Marcos-G/GHOST-LFRArduino-/correccion encoder derecho.png

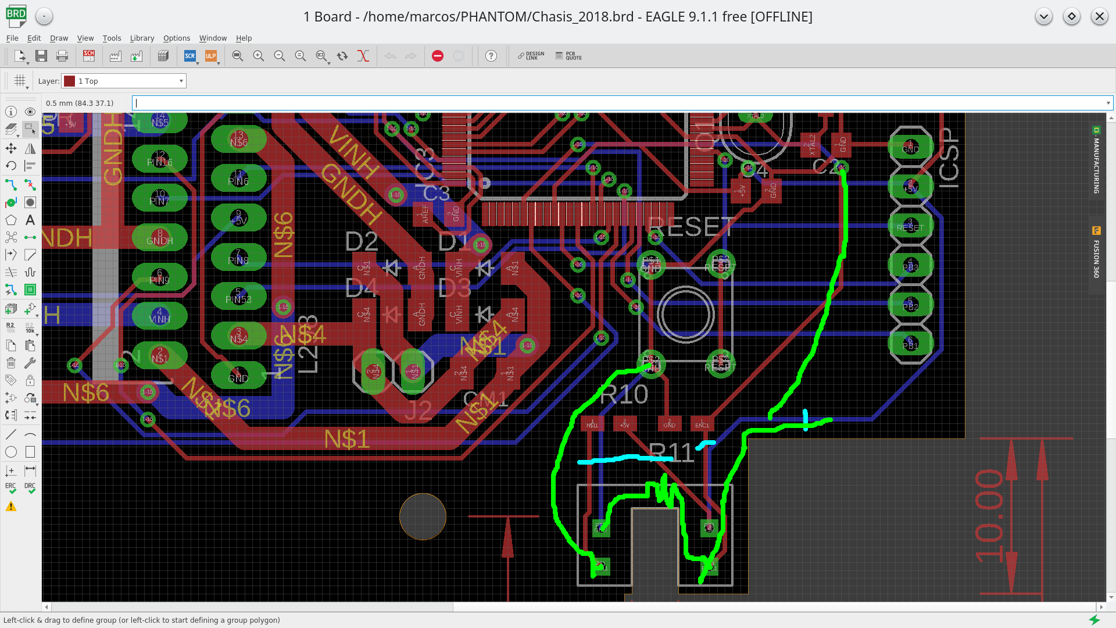
correccion encoder derecho.png
