Marcos-G/GHOST-LFRArduino-/correcion encoder izquierdo.png

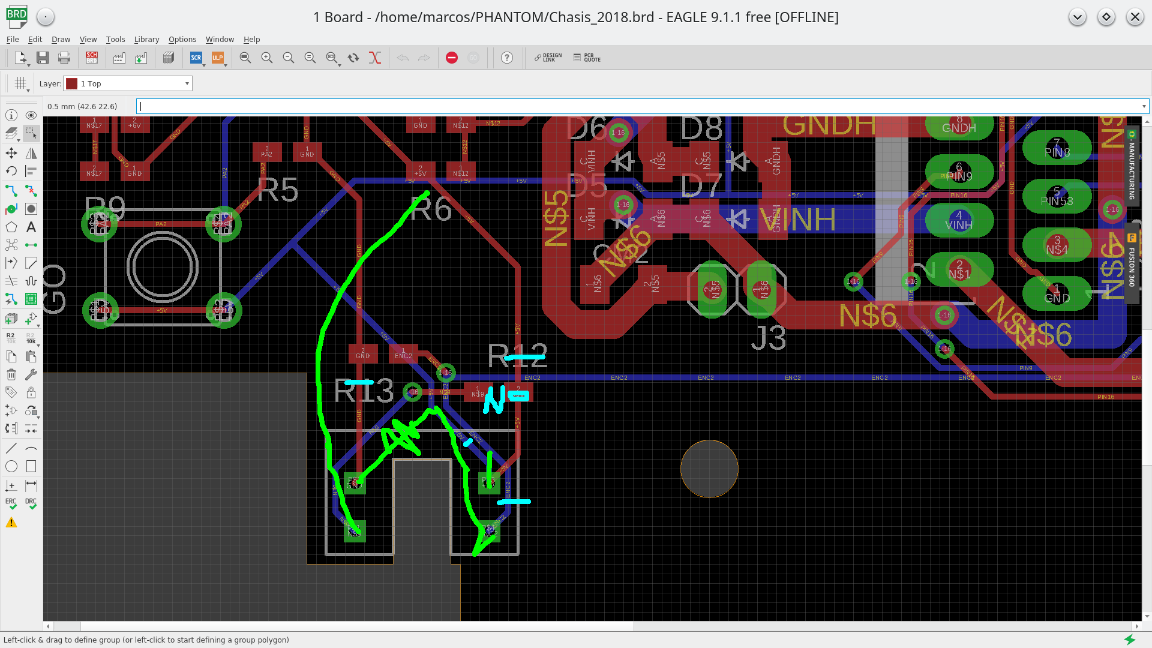
correcion encoder izquierdo.png
