Marcos-G/GHOST-LFRArduino-/Chasis_2018.brd

## EAGLE design Chasis_2018.brd (2018-07-31)

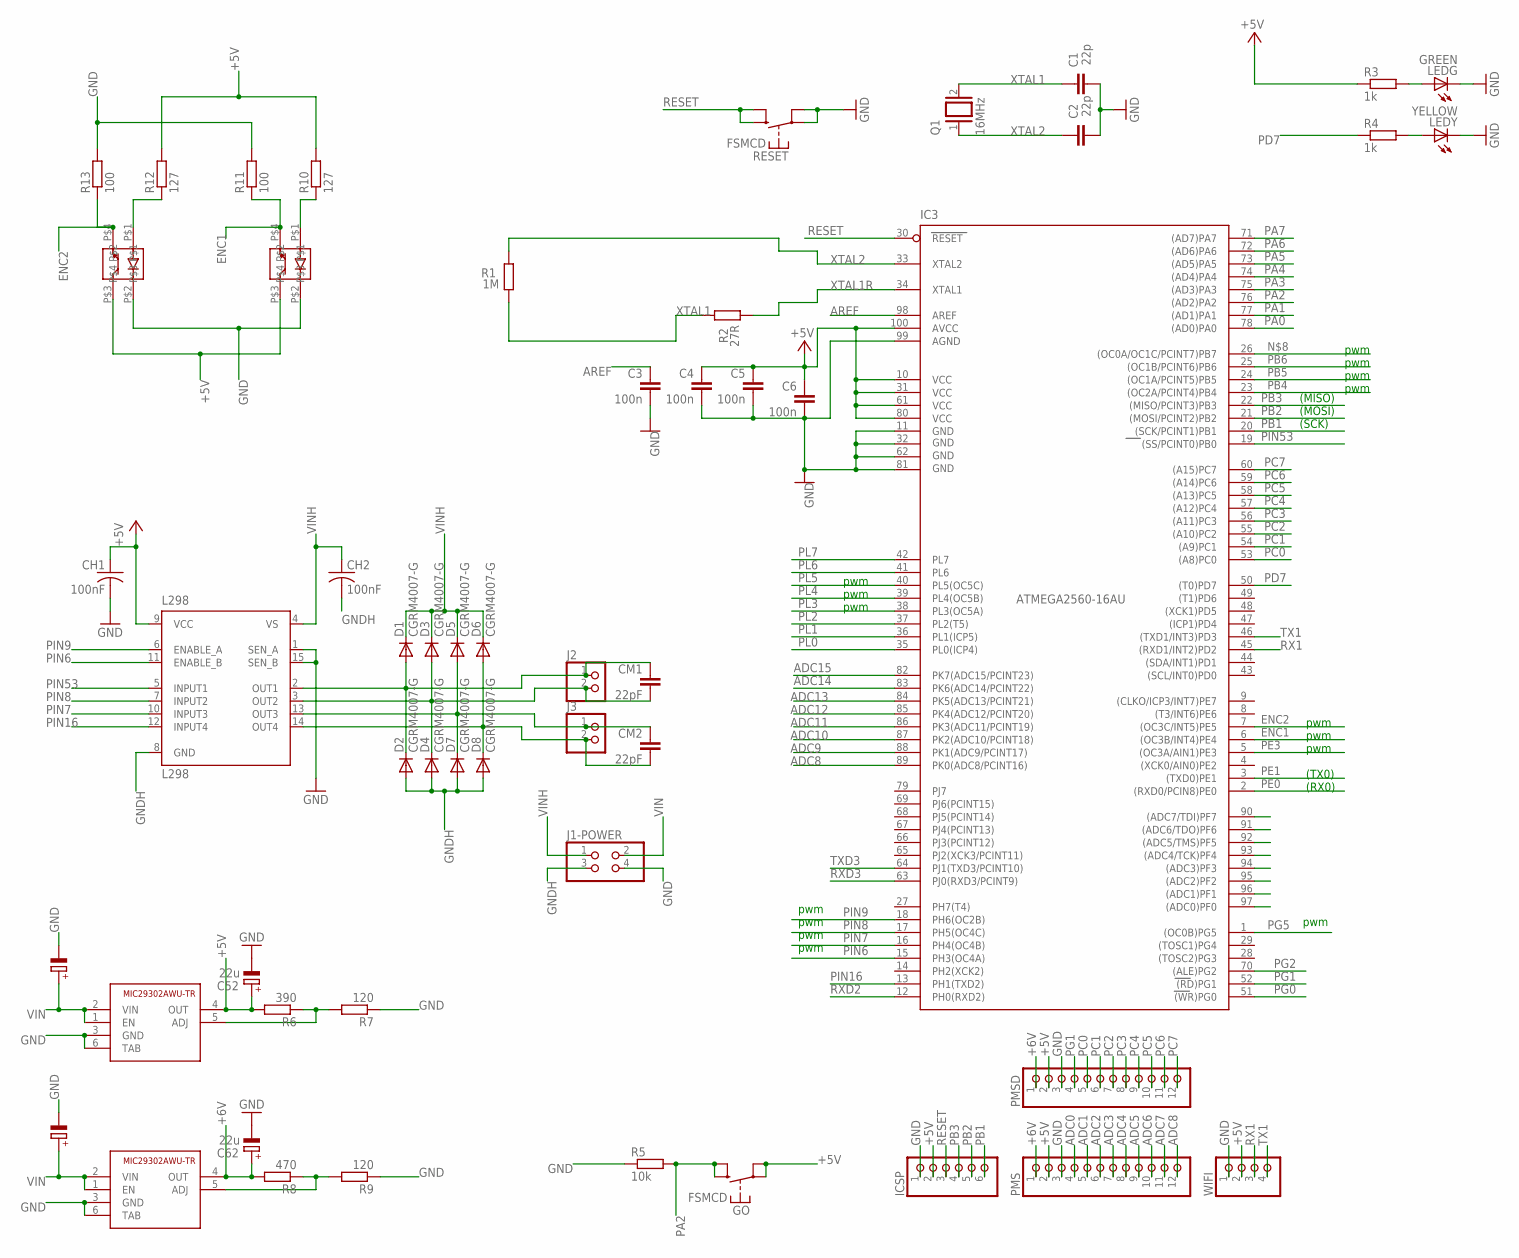
[picture p3: schematic Chasis_2018.sch]

Parts:
C1, C2: 22p; C0805K
C3, C4, C5, C6: 100n; C0805K
C51, C61: 10u; PANASONIC_D
C52, C62: 22u; PANASONIC_D
CH1, CH2: 100nF; C0805K
CM1, CM2: 22pF; C1206K
D1, D2, D3, D4, D5, D6, D7, D8: CGRM4007-G; SOD-123_MINI-SMA
ENC1, ENC2: EE-SX1046
GO: FSMCD
IC3: ATMEGA2560-16AU; TQFP100
ICSP: PINHD-1X6; 1X06
J1-POWER: PINHD-2X2; 2X02
J2, J3: PINHD-1X2; 1X02
L298: L298; MULTIWATT-15
LEDG: GREEN; CHIP-LED0805
LEDY: YELLOW; CHIP-LED0805
PMS: PINHD-1X12; 1X12
PMSD: PINHD-1X12; 1X12
Q1: 16MHz; QS
R1: 1M; R0805W
R2: 27R; R0805W
R3, R4: 1k; R0805W
R5: 10k; R0805W
R6: 390; R0805W
R7, R9: 120; R0805W
R8: 470; R0805W
R10, R12: 127; R0805W
R11, R13: 100; R0805W
REG5V, REG6V: MIC29302AWU-TR; TO263-5
RESET: FSMCD
WIFI: PINHD-1X4; 1X04

Connections:
+5V: C4.1, C5.1, C6.1, C52.+, CH1.1, ENC1.P$3, ENC2.P$3, GO.P$1, GO.P$2, IC3.10 (VCC), IC3.31 (VCC1), IC3.61 (VCC2), IC3.80 (VCC3), IC3.100 (AVCC), ICSP.2, L298.9 (VCC), PMS.2, PMSD.2, R3.1, R6.2, R10.2, R12.2, REG5V.4 (OUT), WIFI.2
+6V: C62.+, PMS.1, PMSD.1, R8.2, REG6V.4 (OUT)
ADC0: IC3.97 ((ADC0)PF0), PMS.4
ADC1: IC3.96 ((ADC1)PF1), PMS.5
ADC2: IC3.95 ((ADC2)PF2), PMS.6
ADC3: IC3.94 ((ADC3)PF3), PMS.7
ADC4: IC3.93 ((ADC4/TCK)PF4), PMS.8
ADC5: IC3.92 ((ADC5/TMS)PF5), PMS.9
ADC6: IC3.91 ((ADC6/TDO)PF6), PMS.10
ADC7: IC3.90 ((ADC7/TDI)PF7), PMS.11
ADC8: IC3.89 (PK0(ADC8/PCINT16)), PMS.12
ADC9: IC3.88 (PK1(ADC9/PCINT17))
ADC10: IC3.87 (PK2(ADC10/PCINT18))
ADC11: IC3.86 (PK3(ADC11/PCINT19))
ADC12: IC3.85 (PK4(ADC12/PCINT20))
ADC13: IC3.84 (PK5(ADC13/PCINT21))
ADC14: IC3.83 (PK6(ADC14/PCINT22))
ADC15: IC3.82 (PK7(ADC15/PCINT23))
AREF: C3.1, IC3.98 (AREF)
ENC1: ENC2.P$4, IC3.6 ((OC3B/INT4)PE4), R11.1
ENC2: ENC1.P$4, IC3.7 ((OC3C/INT5)PE5), R13.1
GND: C1.1, C2.1, C3.2, C4.2, C5.2, C6.2, C51.-, C52.-, C61.-, C62.-, CH1.2, ENC1.P$2, ENC2.P$2, IC3.11 (GND), IC3.32 (GND1), IC3.62 (GND2), IC3.81 (GND3), IC3.99 (AGND), ICSP.1, J1-POWER.4, L298.1 (SEN_A), L298.15 (SEN_B), LEDG.C, LEDY.C, PMS.3, PMSD.3, R5.1, R7.1, R9.1, R11.2, R13.2, REG5V.3 (GND), REG5V.6 (TAB), REG6V.3 (GND), REG6V.6 (TAB), RESET.P$1, RESET.P$2, WIFI.1
GNDH: CH2.2, D2.A, D4.A, D7.A, D8.A, J1-POWER.3, L298.8 (GND)
unnamed: CM1.1, D1.A, D2.C, J2.1, L298.2 (OUT1)
unnamed: LEDY.A, R4.2
unnamed: LEDG.A, R3.2
unnamed: CM1.2, D3.A, D4.C, J2.2, L298.3 (OUT2)
unnamed: CM2.2, D6.A, D8.C, J3.2, L298.14 (OUT4)
unnamed: CM2.1, D5.A, D7.C, J3.1, L298.13 (OUT3)
unnamed: ENC1.P$1, R12.1
unnamed: ENC2.P$1, R10.1
unnamed: R6.1, R7.2, REG5V.5 (ADJ)
unnamed: R8.1, R9.2, REG6V.5 (ADJ)
PA0: IC3.78 ((AD0)PA0)
PA1: IC3.77 ((AD1)PA1)
PA2: GO.P$3 (S), GO.P$4 (S), IC3.76 ((AD2)PA2), R5.2
PA3: IC3.75 ((AD3)PA3)
PA4: IC3.74 ((AD4)PA4)
PA5: IC3.73 ((AD5)PA5)
PA6: IC3.72 ((AD6)PA6)
PA7: IC3.71 ((AD7)PA7)
PB1: IC3.20 ((SCK/PCINT1)PB1), ICSP.6
PB2: IC3.21 ((MOSI/PCINT2)PB2), ICSP.5
PB3: IC3.22 ((MISO/PCINT3)PB3), ICSP.4
PB4: IC3.23 ((OC2A/PCINT4)PB4)
PB5: IC3.24 ((OC1A/PCINT5)PB5)
PB6: IC3.25 ((OC1B/PCINT6)PB6)
PC0: IC3.53 ((A8)PC0), PMSD.5
PC1: IC3.54 ((A9)PC1), PMSD.6
PC2: IC3.55 ((A10)PC2), PMSD.7
PC3: IC3.56 ((A11)PC3), PMSD.8
PC4: IC3.57 ((A12)PC4), PMSD.9
PC5: IC3.58 ((A13)PC5), PMSD.10
PC6: IC3.59 ((A14)PC6), PMSD.11
PC7: IC3.60 ((A15)PC7), PMSD.12
PD7: IC3.50 ((T0)PD7), R4.1
PE0: IC3.2 ((RXD0/PCIN8)PE0)
PE1: IC3.3 ((TXD0)PE1)
PE3: IC3.5 ((OC3A/AIN1)PE3)
PG0: IC3.51 ((WR)PG0)
PG1: IC3.52 ((RD)PG1), PMSD.4
PG2: IC3.70 ((ALE)PG2)
PG5: IC3.1 ((OC0B)PG5)
PIN6: IC3.15 (PH3(OC4A)), L298.11 (ENABLE_B)
PIN7: IC3.16 (PH4(OC4B)), L298.10 (INPUT3)
PIN8: IC3.17 (PH5(OC4C)), L298.7 (INPUT2)
PIN9: IC3.18 (PH6(OC2B)), L298.6 (ENABLE_A)
PIN16: IC3.13 (PH1(TXD2)), L298.12 (INPUT4)
PIN53: IC3.19 ((SS/PCINT0)PB0), L298.5 (INPUT1)
PL0: IC3.35 (PL0(ICP4))
PL1: IC3.36 (PL1(ICP5))
PL2: IC3.37 (PL2(T5))
PL3: IC3.38 (PL3(OC5A))
PL4: IC3.39 (PL4(OC5B))
PL5: IC3.40 (PL5(OC5C))
PL6: IC3.41 (PL6)
PL7: IC3.42 (PL7)
RESET: IC3.30 (RESET), ICSP.3, RESET.P$3 (S), RESET.P$4 (S)
RX1: IC3.45 ((RXD1/INT2)PD2), WIFI.3
RXD2: IC3.12 (PH0(RXD2))
RXD3: IC3.63 (PJ0(RXD3/PCINT9))
TX1: IC3.46 ((TXD1/INT3)PD3), WIFI.4
TXD3: IC3.64 (PJ1(TXD3/PCINT10))
VIN: C51.+, C61.+, J1-POWER.2, REG5V.1 (EN), REG5V.2 (VIN), REG6V.1 (EN), REG6V.2 (VIN)
VINH: CH2.1, D1.C, D3.C, D5.C, D6.C, J1-POWER.1, L298.4 (VS)
XTAL1: C1.2, Q1.2, R1.1, R2.2
XTAL1R: IC3.34 (XTAL1), R2.1
XTAL2: C2.2, IC3.33 (XTAL2), Q1.1, R1.2

Notes on the sheet:
pwm
(TX0)
(RX0)
(MISO)
(SCK)
(MOSI)

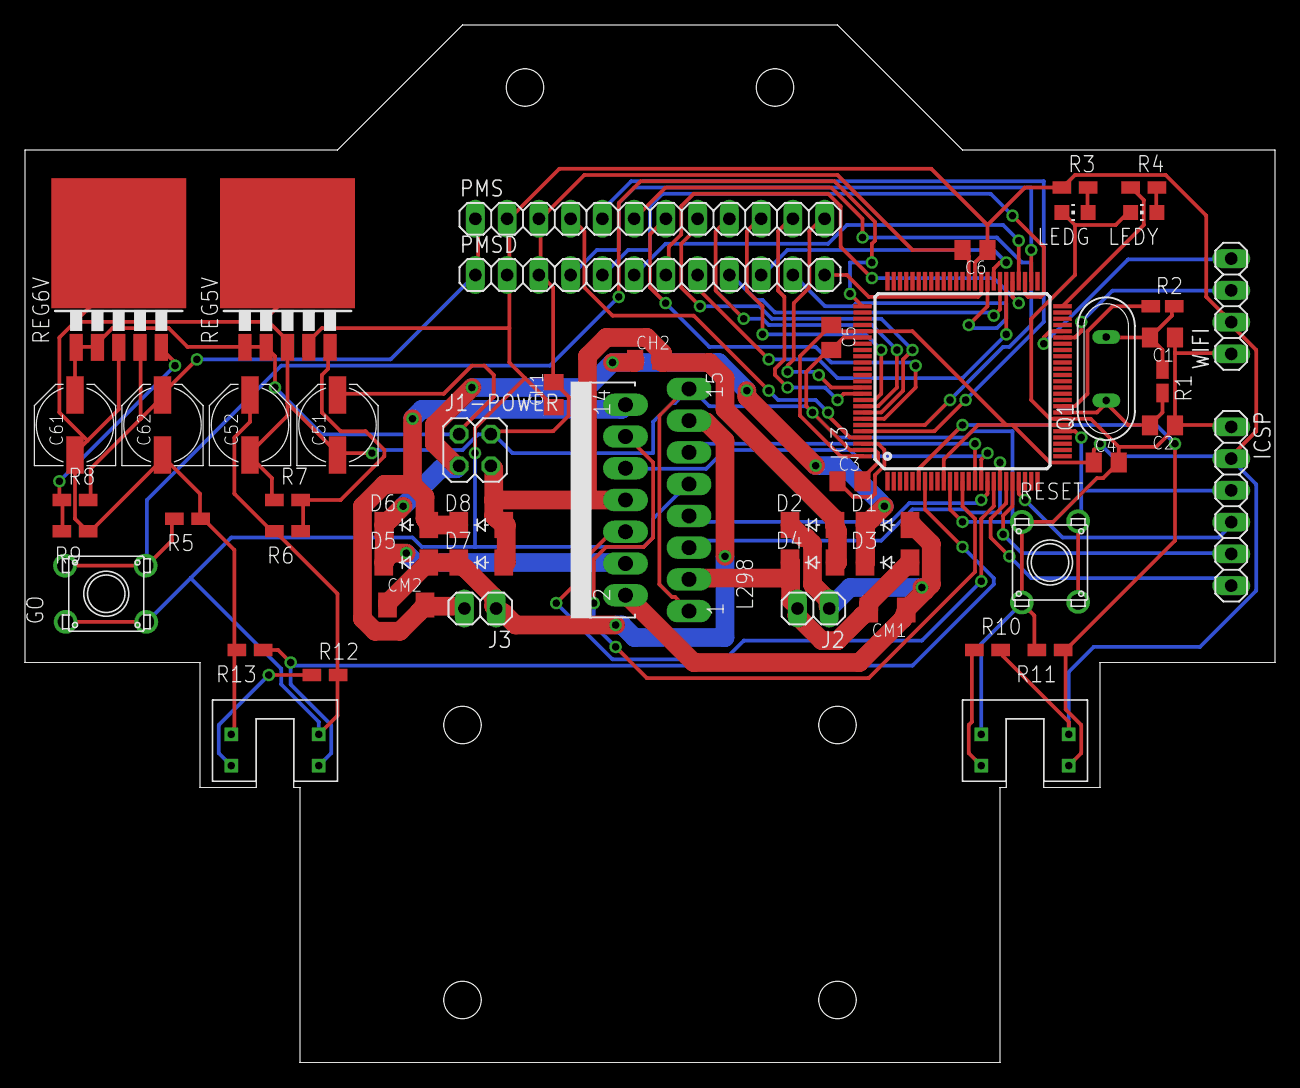
[picture p4: board Chasis_2018.brd from above]

Board: 2 copper layers, 100.0 x 83.0 mm, 53 parts (0 on the bottom side), 54 nets.
