Marcos-G/GHOST-LFRArduino-/Sensores_2018.brd

## EAGLE design Sensores_2018.brd (2018-07-31)

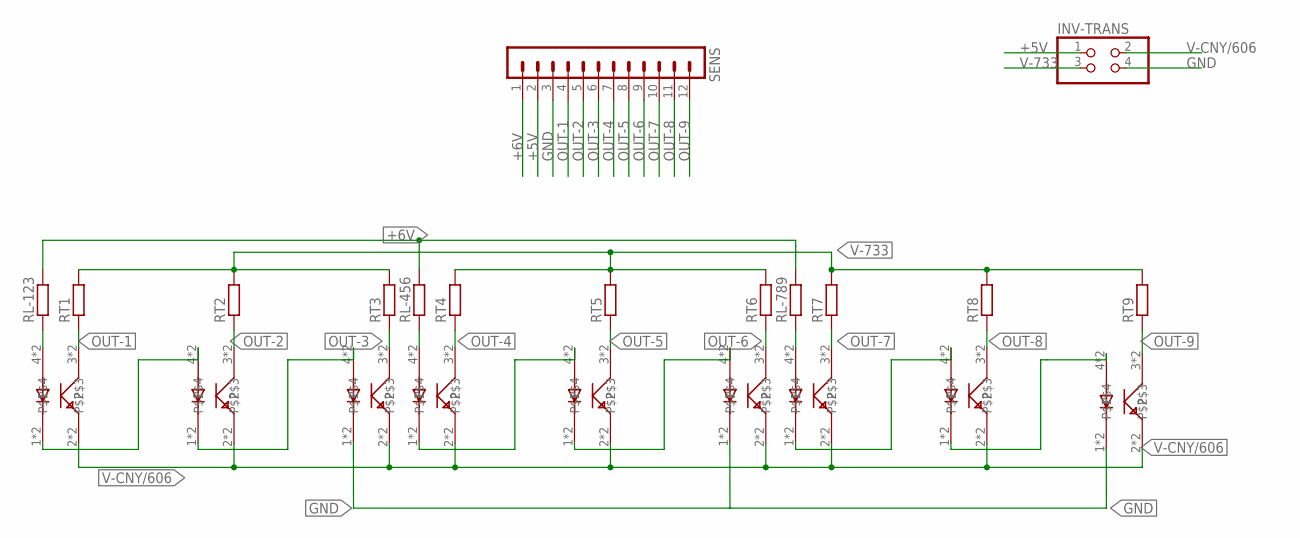
[picture p5: schematic Sensores_2018.sch]

Parts:
INV-TRANS: PINHD-2X2; 2X02
RL-123, RL-456, RL-789: R-EU_R0805W; R0805W
RT1, RT2, RT3, RT4, RT5, RT6, RT7, RT8, RT9: R-EU_R0805W; R0805W
S1, S2, S3, S4, S5, S6, S7, S8, S9: OPB733+OPB606+CNY70; OPB733+606
SENS: MA12-1

Connections:
+5V: INV-TRANS.1, SENS.2
+6V: RL-123.2, RL-456.2, RL-789.2, SENS.1
GND: INV-TRANS.4, S3.1, S3.P$1, S6.1, S6.P$1, S9.1, S9.P$1, SENS.3
unnamed: RL-123.1, S1.4, S1.P$4
unnamed: S1.1, S1.P$1, S2.4, S2.P$4
unnamed: S2.1, S2.P$1, S3.4, S3.P$4
unnamed: RL-456.1, S4.4, S4.P$4
unnamed: S4.1, S4.P$1, S5.4, S5.P$4
unnamed: S5.1, S5.P$1, S6.4, S6.P$4
unnamed: RL-789.1, S7.4, S7.P$4
unnamed: S7.1, S7.P$1, S8.4, S8.P$4
unnamed: S8.1, S8.P$1, S9.4, S9.P$4
OUT-1: RT1.1, S1.3, S1.P$3, SENS.4
OUT-2: RT2.1, S2.3, S2.P$3, SENS.5
OUT-3: RT3.1, S3.3, S3.P$3, SENS.6
OUT-4: RT4.1, S4.3, S4.P$3, SENS.7
OUT-5: RT5.1, S5.3, S5.P$3, SENS.8
OUT-6: RT6.1, S6.3, S6.P$3, SENS.9
OUT-7: RT7.1, S7.3, S7.P$3, SENS.10
OUT-8: RT8.1, S8.3, S8.P$3, SENS.11
OUT-9: RT9.1, S9.3, S9.P$3, SENS.12
V-733: INV-TRANS.3, RT1.2, RT2.2, RT3.2, RT4.2, RT5.2, RT6.2, RT7.2, RT8.2, RT9.2
V-CNY/606: INV-TRANS.2, S1.2, S1.P$2, S2.2, S2.P$2, S3.2, S3.P$2, S4.2, S4.P$2, S5.2, S5.P$2, S6.2, S6.P$2, S7.2, S7.P$2, S8.2, S8.P$2, S9.2, S9.P$2

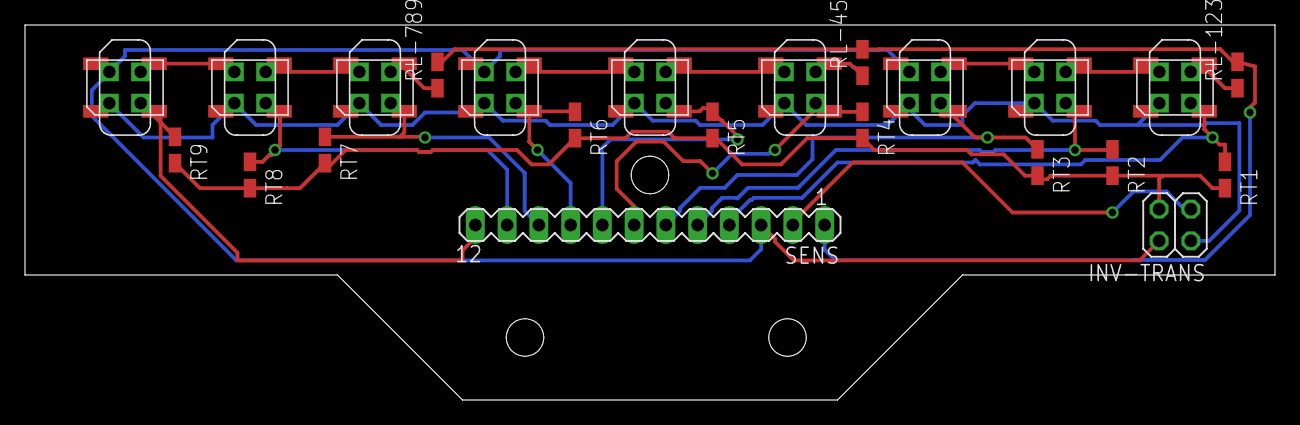
[picture p6: board Sensores_2018.brd from above]

Board: 2 copper layers, 100.0 x 30.0 mm, 23 parts (0 on the bottom side), 23 nets.
