Marcos-G/GHOST-LFRArduino-/main/storage.ino

/*#include <EEPROM.h>
  int dirs[]={0,sizeof(double),sizeof(double)*2,sizeof(double)*3,sizeof(double)*3+sizeof(int),sizeof(double)*3+sizeof(int)*2,sizeof(double)*4+sizeof(int)*2};
  void guardarData(){
  EEPROM.put(kp,dirs[0]);
  EEPROM.put(ki,dirs[1]);
  EEPROM.put(kd,dirs[2]);
  EEPROM.put(vel,dirs[3]);
  EEPROM.put(usr,dirs[4]);
  EEPROM.put(kFrenoD,dirs[5]);
  EEPROM.put(kFrenoP,dirs[6]);
  }
  void leerData(){
  EEPROM.get(dirs[0],kp);
  EEPROM.get(dirs[1],ki);
  EEPROM.get(dirs[2],kd);
  //EEPROM.get(dirs[3],vel);
  EEPROM.get(dirs[4],usr);
  EEPROM.get(dirs[5],kFrenoD);
  EEPROM.get(dirs[6],kFrenoP);
  }
*/
