Marcos-G/GHOST-LFRArduino-/tests/7_driver/7_driver.ino

// Motor A
int ENA = 9;
int IN1 = 53;
int IN2 = 8;

// Motor B
int ENB = 6;
int IN3 = 7;
int IN4 = 16;

void setup ()
{
 // Declaramos todos los pines como salidas
 pinMode (ENA, OUTPUT);
 pinMode (ENB, OUTPUT);
 pinMode (IN1, OUTPUT);
 pinMode (IN2, OUTPUT);
 pinMode (IN3, OUTPUT);
 pinMode (IN4, OUTPUT);
}
void Adelante ()
{
 //Direccion motor A
 digitalWrite (IN1, HIGH);
 digitalWrite (IN2, LOW);
 analogWrite (ENA, 255); //Velocidad motor A
 //Direccion motor B
 digitalWrite (IN3, HIGH);
 digitalWrite (IN4, LOW);
 analogWrite (ENB, 255); //Velocidad motor B
}
void Atras ()
{
 //Direccion motor A
 digitalWrite (IN1, LOW);
 digitalWrite (IN2, HIGH);
 analogWrite (ENA, 128); //Velocidad motor A
 //Direccion motor B
 digitalWrite (IN3, LOW);
 digitalWrite (IN4, HIGH);
 analogWrite (ENB, 128); //Velocidad motor B
}
void Derecha ()
{
 //Direccion motor A
 digitalWrite (IN1, HIGH);
 digitalWrite (IN2, LOW);
 analogWrite (ENA, 200); //Velocidad motor A
 //Direccion motor B
 digitalWrite (IN3, LOW);
 digitalWrite (IN4, HIGH);
 analogWrite (ENB, 100); //Velocidad motor A
}

void Izquierda ()
{
 //Direccion motor A
 digitalWrite (IN1, LOW);
 digitalWrite (IN2, HIGH);
 analogWrite (ENA, 50); //Velocidad motor A
 //Direccion motor B
 digitalWrite (IN3, HIGH);
 digitalWrite (IN4, LOW);
 analogWrite (ENB, 150); //Velocidad motor A
}
void Parar ()
{
 //Direccion motor A
 digitalWrite (IN1, LOW);
 digitalWrite (IN2, LOW);
 analogWrite (ENA, 0); //Velocidad motor A
 //Direccion motor B
 digitalWrite (IN3, LOW);
 digitalWrite (IN4, LOW);
 analogWrite (ENB, 0); //Velocidad motor A
}
void loop ()
{
 Adelante();
 delay(4000);
 Atras();
 delay(4000);
 Izquierda();
 delay(4000);
 Derecha();
 delay(4000);
 Parar();
 delay(4000);
}
