Marcos-G/GHOST-LFRArduino-/tests/1_blinkLed/1_blinkLed.ino

void setup() {
  // initialize digital pin LED_BUILTIN as an output.
  pinMode(38, OUTPUT);
}

// the loop function runs over and over again forever
void loop() {
  digitalWrite(38, HIGH);   // turn the LED on (HIGH is the voltage level)
  delay(1000);                       // wait for a second
  digitalWrite(38, LOW);    // turn the LED off by making the voltage LOW
  delay(1000);                       // wait for a second
}
